mkeller0815/VC4000MultiROM/doc/IMG_2645.JPG

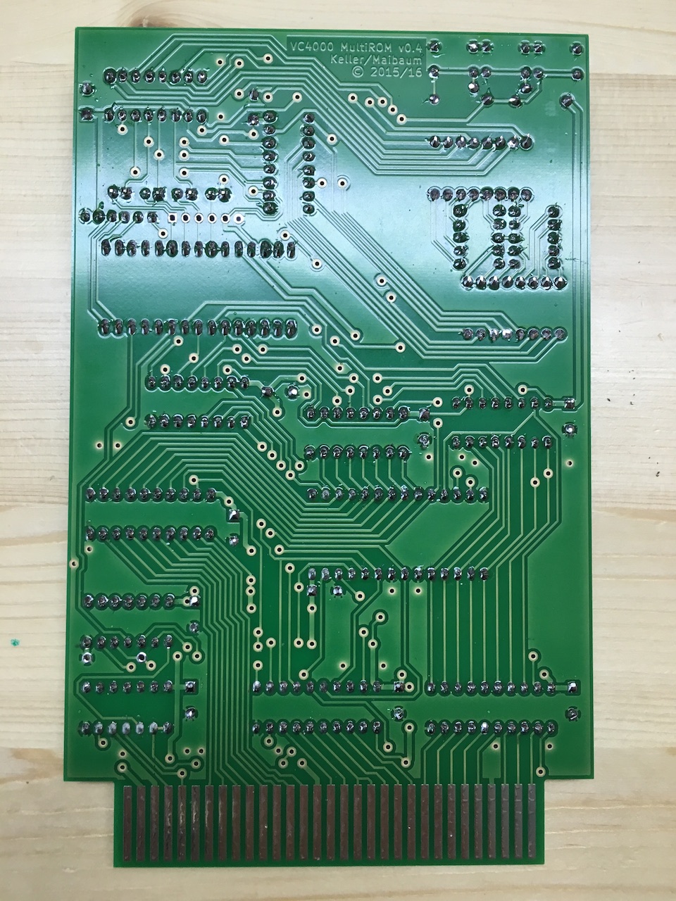
doc/IMG_2645.JPG
