mkeller0815/VC4000MultiROM/doc/IMG_2644.JPG

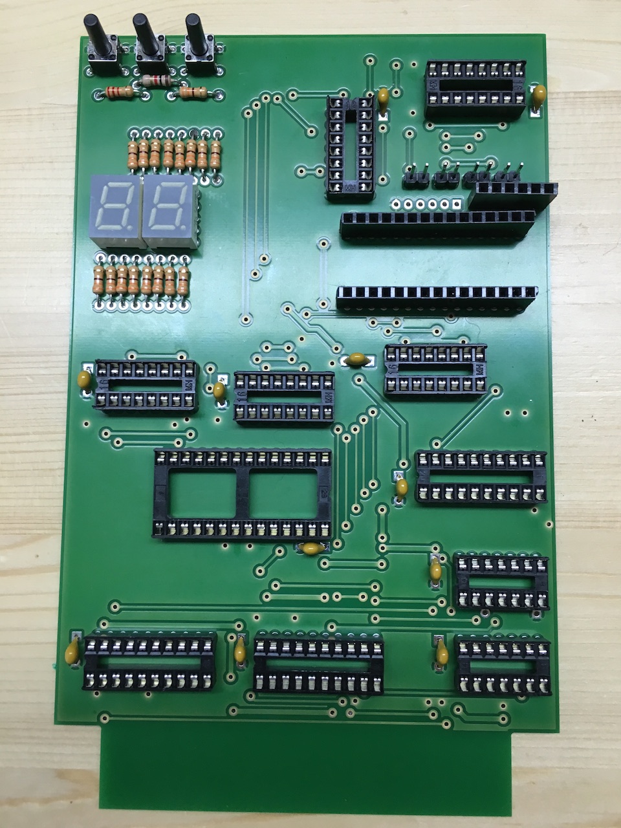
doc/IMG_2644.JPG
