mkeller0815/VC4000MultiROM/README.md

VC4000 MultiRom Modul
=====================

This is the approach to implement a MultiRom modul for the Interton VC4000.

![Overview] (https://github.com/mkeller0815/VC4000MultiROM/blob/master/doc/multirom_overview.jpg)
