mkeller0815/VC4000MultiROM/doc/README.md

Overview of ROM compatibility
=============================

Status Explanation (from good to bad)
-------------------------------------
*WORKS* - Seems to work, e.g. the game LOADS, starts and is playable. Did not
test every corner case, though.

*LOADS* – It loads into some 'stable' start screen, but does not seem
playable. Could mean, that I just don't now how to play this game, but just
tried to press any button and did not see any reaction on screen.

*FAILS* – Does not load, glitches horribly, or is not playable at all for any
other reason.

*n/a* – Not yet tested.

ROM Status Table
----------------

**Statistics at 43c7404**
- *WORKS:* 24/40 (60%)
- *LOADS:* 4/40 (10%)
- *FAILS:* 12/40 (30%)

ROM file     | Type | Status | Last tested with FW commit
------------:|:-----|:-------|---------------------------
 4inarow.bin | 2K   | WORKS  | 533253a
asattack.bin | 2K   | WORKS  | 533253a
asbattle.bin | 2K   | WORKS  | 533253a
backgamn.bin | 4K+1K| WORKS  | 533253a
blackjac.bin | 2K   | WORKS  | 533253a
 bowling.bin | 2K   | WORKS  | 533253a
  boxing.bin | 4K   | WORKS  | 533253a
 capture.bin | 2K   | WORKS  | 533253a
carraces.bin | 2K   | WORKS  | 533253a
  casino.bin | 2K   | WORKS  | 533253a
  chess1.bin | 4K+1K| WORKS  | 533253a
  chess2.bin | 6K+1K| FAILS  | 5a9af7a
 codebrk.bin | 2K   | WORKS  | 43c7404
 combata.bin | 2K   | WORKS  | 533253a
 combatb.bin | 2K   | WORKS  | 533253a
  cowboy.bin | 2K   | WORKS  | 43c7404
 draughts.bin| 4K+1K| WORKS  | 533253a
grndprix.bin | 2K   | WORKS  | 533253a
  headon.bin | 2K   | WORKS  | 43c7404
hippodro.bin | 2K   | WORKS  | 533253a
horsrace.bin | 2K   | WORKS  | 533253a
 hunting.bin | 2K   | WORKS  | 43c7404
hyprspac.bin | 2K   | WORKS  | 533253a
invadera.bin | 2K   | WORKS  | 43c7404
invaderb.bin | 2K   | WORKS  | 43c7404
knockout.bin | 2K   | WORKS  | 43c7404
labyrint.bin | 2K   | WORKS  | 43c7404
laseratt.bin | 2K   | WORKS  | 43c7404
mathema1.bin | 2K   | WORKS  | 533253a
mathema2.bin | 2K   | WORKS  | 533253a
mmuncher.bin | 2K   | WORKS  | 43c7404
musicalg.bin | 2K   | WORKS  | 43c7404
olympics.bin | 2K   | WORKS  | 43c7404
pinballa.bin | 2K   | WORKS  | 43c7404
pinballb.bin | 2K   | WORKS  | 43c7404
planetde.bin | 2K   | WORKS  | 43c7404
shootgal.bin | 2K   | WORKS  | 43c7404
shootout.bin | 2K   | WORKS  | 43c7404
 soccera.bin | 2K   | WORKS  | 43c7404
 soccerb.bin | 2K   | WORKS  | 43c7404
solitair.bin | 2K   | WORKS  | 533253a
spacewar.bin | 2K   | WORKS  | 43c7404
superinv.bin | 2K   | WORKS  | 533253a
suprmaze.bin | 2K   | WORKS  | 43c7404
treasure.bin | 2K   | WORKS  | 43c7404
