mkeller0815/VC4000MultiROM/doc/IMG_2646.JPG

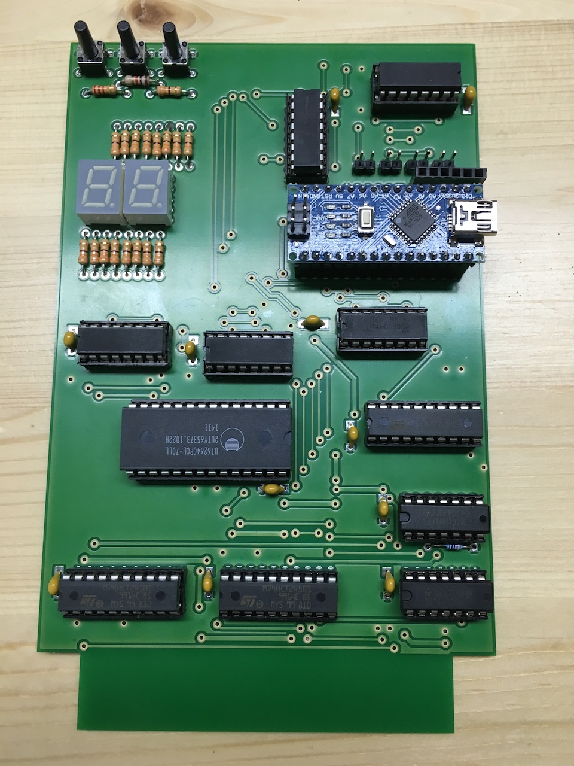
doc/IMG_2646.JPG
