mkeller0815/VC4000MultiROM/doc/multirom_overview.jpg

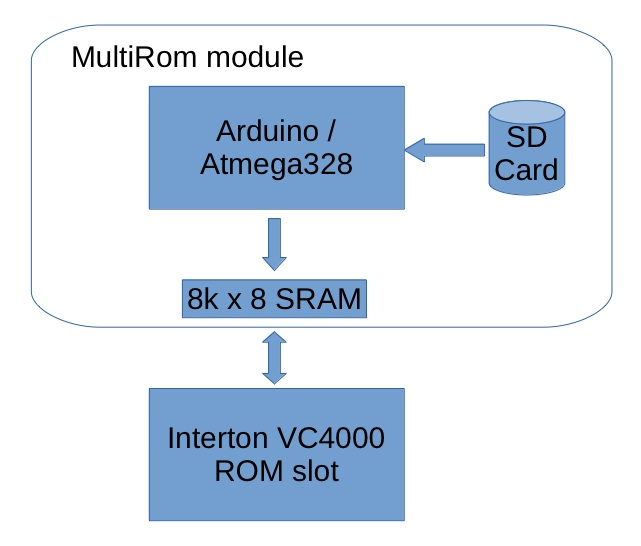
doc/multirom_overview.jpg
