mkeller0815/VC4000MultiROM/(list of files, drawings)

Other design files:
hardware/ROMCardPrototype/Mutilrom_1.dip
