mkeller0815/VC4000MultiROM/hardware/MultiRomCard.kicad_pcb

## KiCad design hardware/MultiRomCard.kicad_pcb (2016-09-15)

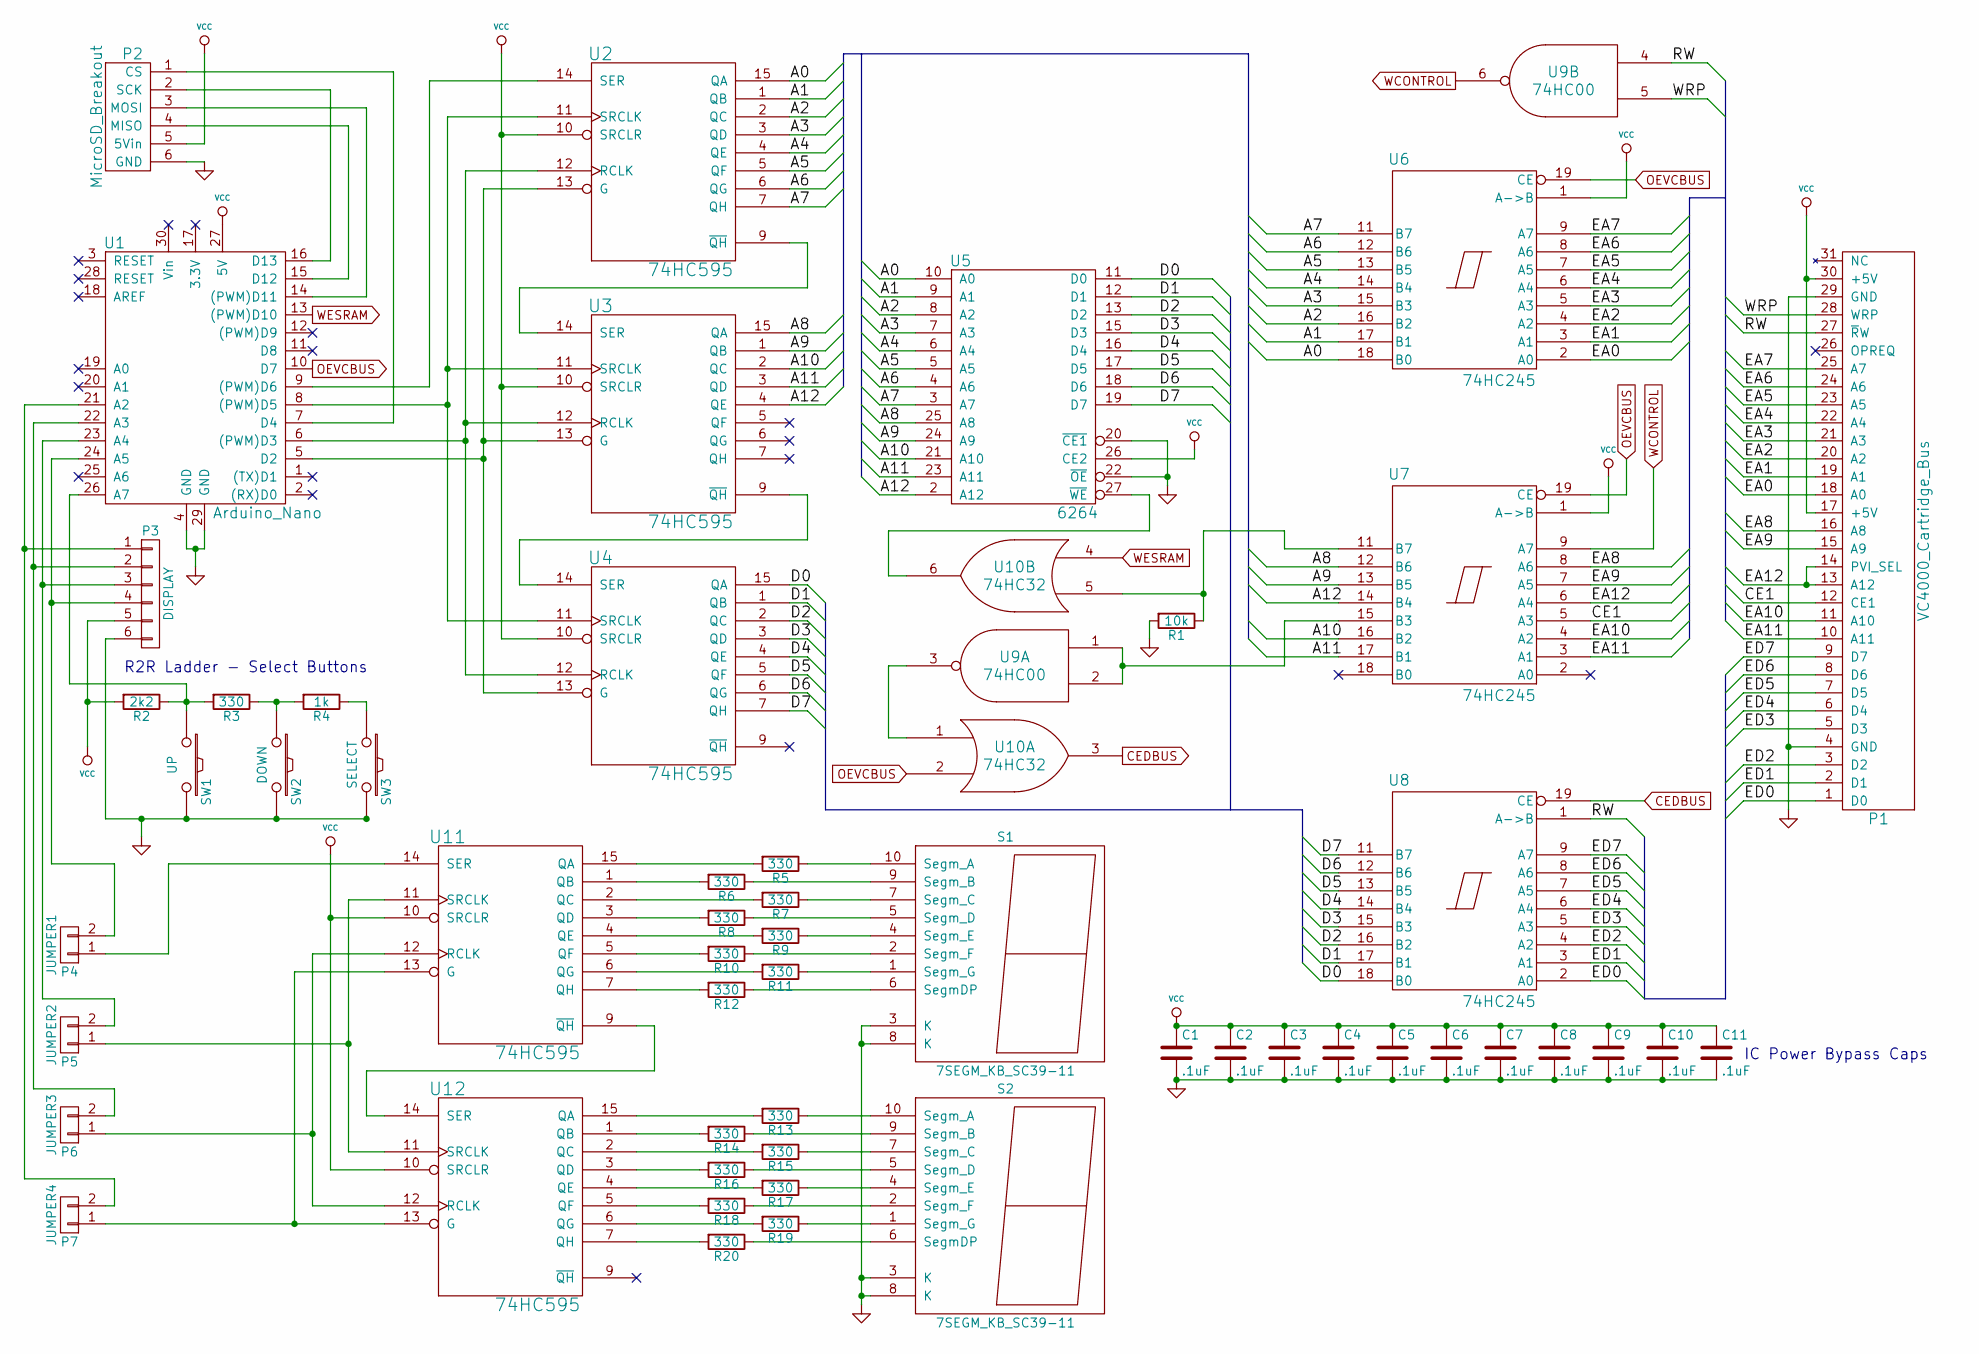
[picture p5: schematic MultiRomCard.sch, Interton VC4000 MultiRom Cartridge]

Parts:
C1, C2, C3, C4, C5, C6, C7, C8, C9, C10, C11: .1uF; C_Rect_L7_W2_P5_DIY
P1: VC4000_Cartridge_Bus; VC4000_CartridgeBus
P2: MicroSD_Breakout; Pin_Header_Straight_1x06
P3: DISPLAY; Pin_Header_Straight_1x06
P4: JUMPER1; Pin_Header_Straight_1x02
P5: JUMPER2; Pin_Header_Straight_1x02
P6: JUMPER3; Pin_Header_Straight_1x02
P7: JUMPER4; Pin_Header_Straight_1x02
R1: 10k; Resistor_Horizontal_RM10mm
R2: 2k2; Resistor_Horizontal_RM10mm
R3, R5, R6, R7, R8, R9, R10, R11, R12, R13, R14, R15, R16, R17, R18, R19, R20: 330; Resistor_Horizontal_RM10mm
R4: 1k; Resistor_Horizontal_RM10mm
S1, S2: 7SEGM_KB_SC39-11; 7_Segment_Display_KB_13_10mm
SW1: UP; SW_PUSH_SMALL
SW2: DOWN; SW_PUSH_SMALL
SW3: SELECT; SW_PUSH_SMALL
U1: Arduino_Nano
U2, U3, U4, U11, U12: 74HC595; DIP-16_W7.62mm_LongPads
U5: 6264; DIP-28_W15.24mm_LongPads
U6, U7, U8: 74HC245; DIP-20_W7.62mm_LongPads
U9: 74HC00; DIP-14_W7.62mm_LongPads
U10: 74HC32; DIP-14_W7.62mm_LongPads

Connections:
/A0: U2.15 (QA), U5.10 (A0), U6.18 (B0)
/A1: U2.1 (QB), U5.9 (A1), U6.17 (B1)
/A2: U2.2 (QC), U5.8 (A2), U6.16 (B2)
/A3: U2.3 (QD), U5.7 (A3), U6.15 (B3)
/A4: U2.4 (QE), U5.6 (A4), U6.14 (B4)
/A5: U2.5 (QF), U5.5 (A5), U6.13 (B5)
/A6: U2.6 (QG), U5.4 (A6), U6.12 (B6)
/A7: U2.7 (QH), U5.3 (A7), U6.11 (B7)
/A8: U3.15 (QA), U5.25 (A8), U7.12 (B6)
/A9: U3.1 (QB), U5.24 (A9), U7.13 (B5)
/A10: U3.2 (QC), U5.21 (A10), U7.16 (B2)
/A11: U3.3 (QD), U5.23 (A11), U7.17 (B1)
/A12: U3.4 (QE), U5.2 (A12), U7.14 (B4)
/CE1: P1.12 (CE1), U7.5 (A3)
/D0: U4.15 (QA), U5.11 (D0), U8.18 (B0)
/D1: U4.1 (QB), U5.12 (D1), U8.17 (B1)
/D2: U4.2 (QC), U5.13 (D2), U8.16 (B2)
/D3: U4.3 (QD), U5.15 (D3), U8.15 (B3)
/D4: U4.4 (QE), U5.16 (D4), U8.14 (B4)
/D5: U4.5 (QF), U5.17 (D5), U8.13 (B5)
/D6: U4.6 (QG), U5.18 (D6), U8.12 (B6)
/D7: U4.7 (QH), U5.19 (D7), U8.11 (B7)
/EA0: P1.18 (A0), U6.2 (A0)
/EA1: P1.19 (A1), U6.3 (A1)
/EA2: P1.20 (A2), U6.4 (A2)
/EA3: P1.21 (A3), U6.5 (A3)
/EA4: P1.22 (A4), U6.6 (A4)
/EA5: P1.23 (A5), U6.7 (A5)
/EA6: P1.24 (A6), U6.8 (A6)
/EA7: P1.25 (A7), U6.9 (A7)
/EA8: P1.16 (A8), U7.8 (A6)
/EA9: P1.15 (A9), U7.7 (A5)
/EA10: P1.11 (A10), U7.4 (A2)
/EA11: P1.10 (A11), U7.3 (A1)
/EA12: P1.13 (A12), P1.14 (PVI_SEL), U7.6 (A4)
/ED0: P1.1 (D0), U8.2 (A0)
/ED1: P1.2 (D1), U8.3 (A1)
/ED2: P1.3 (D2), U8.4 (A2)
/ED3: P1.5 (D3), U8.5 (A3)
/ED4: P1.6 (D4), U8.6 (A4)
/ED5: P1.7 (D5), U8.7 (A5)
/ED6: P1.8 (D6), U8.8 (A6)
/ED7: P1.9 (D7), U8.9 (A7)
/RW: P1.27 (~R~W), U8.1 (A->B), U9.4
/WRP: P1.28 (WRP), U9.5
CEDBUS: U8.19 (CE), U10.3
GND: C1.2, C2.2, C3.2, C4.2, C5.2, C6.2, C7.2, C8.2, C9.2, C10.2, C11.2, P1.4 (GND), P1.29 (GND), P2.6 (GND), P3.6, R1.2, S1.3 (K), S1.8 (K), S2.3 (K), S2.8 (K), SW1.2, SW2.2, SW3.2, U1.4 (GND), U1.29 (GND), U2.8 (GND), U3.8 (GND), U4.8 (GND), U5.14 (GND), U5.20 (~CE1), U5.22 (~OE), U6.10 (GND), U7.10 (GND), U8.10 (GND), U9.7 (GND), U10.7 (GND), U11.8 (GND), U12.8 (GND)
unnamed: P2.1 (CS), U1.7 (D4)
unnamed: P2.2 (SCK), U1.16 (D13)
unnamed: P2.3 (MOSI), U1.14 ((PWM)D11)
unnamed: P2.4 (MISO), U1.15 (D12)
unnamed: P3.1, P7.2, U1.21 (A2)
unnamed: P3.2, P6.2, U1.22 (A3)
unnamed: P3.3, P5.2, U1.23 (A4)
unnamed: P3.4, P4.2, U1.24 (A5)
unnamed: P4.1, U11.14 (SER)
unnamed: P5.1, U11.11 (SRCLK), U12.11 (SRCLK)
unnamed: P6.1, U11.12 (RCLK), U12.12 (RCLK)
unnamed: P7.1, U11.13 (G), U12.13 (G)
unnamed: R1.1, U7.11 (B7), U10.5
unnamed: R2.1, R3.2, SW1.1, U1.26 (A7)
unnamed: R3.1, R4.2, SW2.1
unnamed: R4.1, SW3.1
unnamed: R5.1, S1.10 (Segm_A)
unnamed: R5.2, U11.15 (QA)
unnamed: R6.1, S1.9 (Segm_B)
unnamed: R6.2, U11.1 (QB)
unnamed: R7.1, S1.7 (Segm_C)
unnamed: R7.2, U11.2 (QC)
unnamed: R8.1, S1.5 (Segm_D)
unnamed: R8.2, U11.3 (QD)
unnamed: R9.1, S1.4 (Segm_E)
unnamed: R9.2, U11.4 (QE)
unnamed: R10.1, S1.2 (Segm_F)
unnamed: R10.2, U11.5 (QF)
unnamed: R11.1, S1.1 (Segm_G)
unnamed: R11.2, U11.6 (QG)
unnamed: R12.1, S1.6 (SegmDP)
unnamed: R12.2, U11.7 (QH)
unnamed: R13.1, S2.10 (Segm_A)
unnamed: R13.2, U12.15 (QA)
unnamed: R14.1, S2.9 (Segm_B)
unnamed: R14.2, U12.1 (QB)
unnamed: R15.1, S2.7 (Segm_C)
unnamed: R15.2, U12.2 (QC)
unnamed: R16.1, S2.5 (Segm_D)
unnamed: R16.2, U12.3 (QD)
unnamed: R17.1, S2.4 (Segm_E)
unnamed: R17.2, U12.4 (QE)
unnamed: R18.1, S2.2 (Segm_F)
unnamed: R18.2, U12.5 (QF)
unnamed: R19.1, S2.1 (Segm_G)
unnamed: R19.2, U12.6 (QG)
unnamed: R20.1, S2.6 (SegmDP)
unnamed: R20.2, U12.7 (QH)
unnamed: U1.5 (D2), U2.13 (G), U3.13 (G), U4.13 (G)
unnamed: U1.6 ((PWM)D3), U2.12 (RCLK), U3.12 (RCLK), U4.12 (RCLK)
unnamed: U1.8 ((PWM)D5), U2.11 (SRCLK), U3.11 (SRCLK), U4.11 (SRCLK)
unnamed: U1.9 ((PWM)D6), U2.14 (SER)
unnamed: U2.9 (~QH), U3.14 (SER)
unnamed: U3.9 (~QH), U4.14 (SER)
unnamed: U7.15 (B3), U9.1, U9.2
unnamed: U9.3, U10.1
unnamed: U5.27 (~WE), U10.6
unnamed: U11.9 (~QH), U12.14 (SER)
OEVCBUS: U1.10 (D7), U6.19 (CE), U7.19 (CE), U10.2
VCC: C1.1, C2.1, C3.1, C4.1, C5.1, C6.1, C7.1, C8.1, C9.1, C10.1, C11.1, P1.17 (+5V), P1.30 (+5V), P2.5 (5Vin), P3.5, R2.2, U1.27 (5V), U2.10 (SRCLR), U2.16 (VCC), U3.10 (SRCLR), U3.16 (VCC), U4.10 (SRCLR), U4.16 (VCC), U5.26 (CE2), U5.28 (VCC), U6.1 (A->B), U6.20 (VCC), U7.1 (A->B), U7.20 (VCC), U8.20 (VCC), U9.14 (VCC), U10.14 (VCC), U11.10 (SRCLR), U11.16 (VCC), U12.10 (SRCLR), U12.16 (VCC)
WCONTROL: U7.9 (A7), U9.6
WESRAM: U1.13 ((PWM)D10), U10.4

Notes on the sheet:
IC Power Bypass Caps
R2R Ladder - Select Buttons

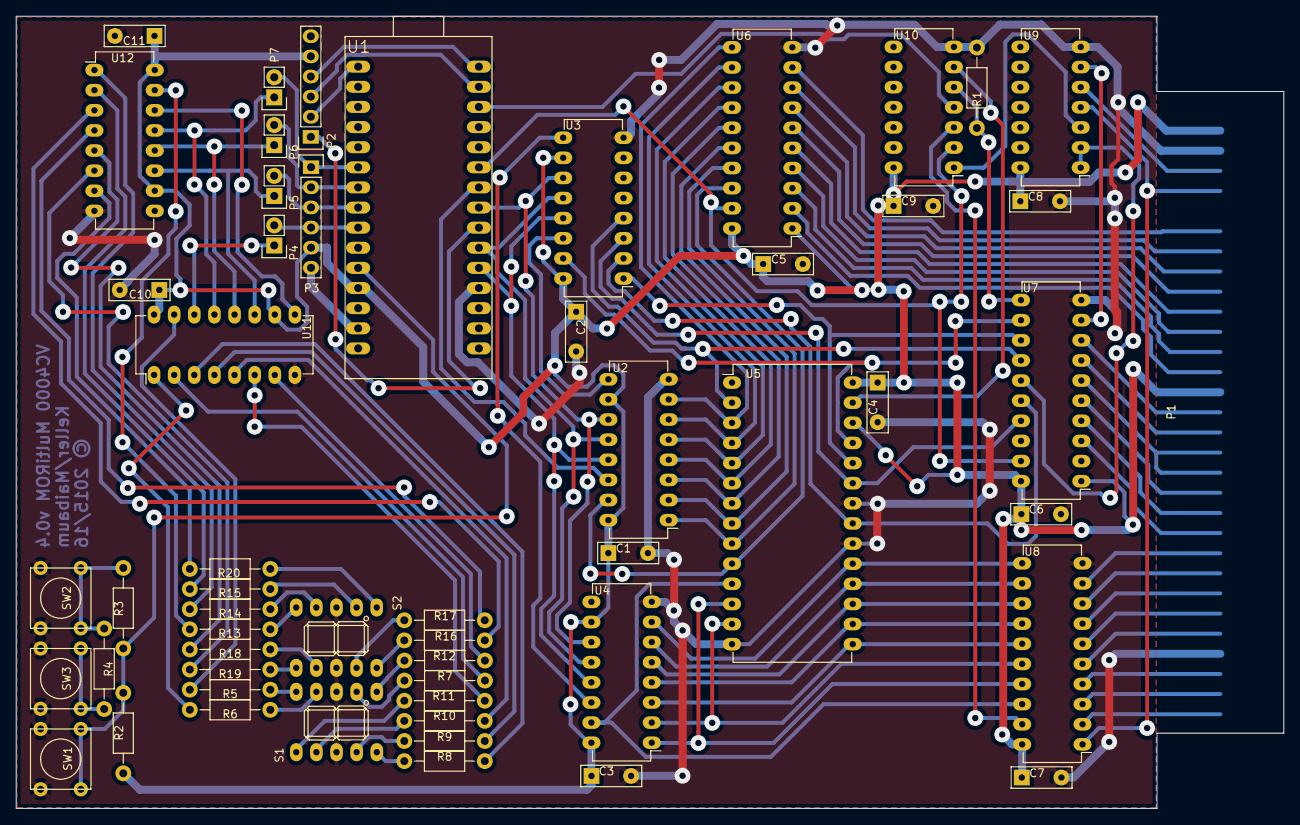
[picture p6: board MultiRomCard.kicad_pcb from above]

Board: 2 copper layers, 160.0 x 100.0 mm, 55 parts (0 on the bottom side), 109 nets.
