mkeller0815/VC4000MultiROM/firmware/MultiRomVC4000/MultiRomVC4000.ino

#include <SD.h>
#include <SPI.h>            // Needed for SD lib

// Defines for Arduino port numbers
#define CLOCK          5  // SRCLK (A/D-Bus Shift Registers)
#define LATCH          3  // RCLK  (A/D-Bus Shift Registers)
#define DATA           6  // SER   (A/D-Bus Shift Registers)
#define OESHIFT        2  // _G    (A/D-Bus Shift Registers)
#define WESRAM        10
#define OEVCBUS        7  // OE for Bus Transceivers
#define SD_CS          4  // Chip Select for SD card

#define DISP_OE       A2  // 7-segment display
#define DISP_LATCH    A3  // 7-segment display
#define DISP_CLK      A4  // 7-segment display
#define DISP_DATA     A5  // 7-segment display

// Miscellaneous other defines
#define NOKEY           0
#define UPKEY           1
#define DOWNKEY         2
#define SELECTKEY       3
#define MAX_ROMS       99
#define MAX_ROM_SIZE 8192
#define GO_MSG          9  // 7-segment Message offset
#define ER_MSG         11  // 7-segment Message offset

// Global variables
byte lastkey = NOKEY;
byte message = GO_MSG;
byte romNumber = 1;
char romName[] = { 0, 0, 0, 0, 0, 0, 0 };
File romFile;
byte SevenSegChar[]= {
  0x3f,  // 0
  0x06,  // 1
  0x5b,  // 2
  0x4f,  // 3
  0x66,  // 4
  0x6d,  // 5
  0x7d,  // 6
  0x07,  // 7
  0x7f,  // 8
  0x6f,  // 9
  0x63,  // o \
  0x79,  // E  |- Additional characters for status messages
  0x50   // r /
};

void setup() {
  pinMode(SD_CS, OUTPUT);
  pinMode(CLOCK, OUTPUT);
  pinMode(LATCH, OUTPUT);
  pinMode(DATA, OUTPUT);
  pinMode(WESRAM, OUTPUT);
  pinMode(OESHIFT, OUTPUT);
  pinMode(OEVCBUS, OUTPUT);
  pinMode(DISP_LATCH, OUTPUT);
  pinMode(DISP_CLK, OUTPUT);
  pinMode(DISP_DATA, OUTPUT);
  pinMode(DISP_OE, OUTPUT);

  // Isolate MultiROM from console bus
  disableVCBus();

  // Enable 7-segment display
  digitalWrite(DISP_OE,LOW);

  // Initialize SD card
  if (SD.begin(SD_CS)) {
    // Wait for user selecting a ROM number
    dispShowNumber(romNumber);
    byte key = getKey(A7);
    do {
      if (key == UPKEY && lastkey != UPKEY && romNumber < MAX_ROMS)
        ++romNumber;
      else if (key == DOWNKEY && lastkey != DOWNKEY && romNumber > 1)
        --romNumber;
      dispShowNumber(romNumber);
      lastkey = key;
      key = getKey(A7);
    } while (key != SELECTKEY);

    // Construct ROM file name
    if (romNumber < 10) {
      romName[0] = '0';
      itoa(romNumber, romName+1, 10);
    } else {
      itoa(romNumber, romName, 10);
    }
    strcpy(romName+2, ".bin");  // Append filename extension

    // Open ROM file
    romFile = SD.open(romName);

    // Write ROM file to SRAM
    if (romFile) {
      unsigned romSize = static_cast<unsigned>(romFile.size());
      if (romSize <= MAX_ROM_SIZE) {
        for (unsigned i = 0; i < romSize; i++) {
          write2RAM(i, romFile.read());
        }
      } else {
        // ROM size too big.
        message = ER_MSG;
      }
      romFile.close();
      enableVCBus();
    } else {
      // ROM file could not be opened.
      message = ER_MSG;
    }
  } else {
    // SD card not found or otherwise failing initialization
    message = ER_MSG;
  }
}

void loop() {
  // Status indication
  dispMessage(message);
}

void disableVCBus() {
  digitalWrite(WESRAM, HIGH);
  digitalWrite(OESHIFT, LOW);
  digitalWrite(OEVCBUS, HIGH);
}

void enableVCBus() {
  digitalWrite(WESRAM, HIGH);
  digitalWrite(OESHIFT, HIGH);
  digitalWrite(OEVCBUS, LOW);
  delay(100);
  // handover R/W control to VC4000
  digitalWrite(WESRAM, LOW);
}

void write2RAM(unsigned int address, byte data) {
  digitalWrite(OESHIFT, LOW);
  digitalWrite(WESRAM, HIGH);
  shiftout(address, data);
  digitalWrite(WESRAM, LOW);
  delayMicroseconds(10);
  digitalWrite(WESRAM, HIGH);
}

void shiftout(unsigned int address, byte data) {
  byte lowbyte = address & 0xff;
  byte highbyte = address >> 8;

  digitalWrite(LATCH, LOW);
  shiftOut(DATA, CLOCK, MSBFIRST, data);
  shiftOut(DATA, CLOCK, MSBFIRST, highbyte);
  shiftOut(DATA, CLOCK, MSBFIRST, lowbyte);
  digitalWrite(LATCH, HIGH);
  delayMicroseconds(10);
  digitalWrite(LATCH, LOW);
}

byte getKey(int pin) {
  int v = analogRead(pin);
  delay(50);
  v = analogRead(pin);
  if (v < 600 && v > 300)
    return DOWNKEY;
  if (v < 300 && v > 100)
    return SELECTKEY;
  if (v < 100)
    return UPKEY;
  return NOKEY;
}

void dispShowNumber(byte num) {
  byte i = num % 10;
  byte j = (num - i) / 10;
  digitalWrite(DISP_LATCH, LOW);
  shiftOut(DISP_DATA, DISP_CLK, MSBFIRST, SevenSegChar[i]); // digitTwo
  shiftOut(DISP_DATA, DISP_CLK, MSBFIRST, SevenSegChar[j]); // digitOne
  digitalWrite(DISP_LATCH, HIGH);
}

void dispMessage(byte offset) {
  digitalWrite(DISP_LATCH, LOW);
  shiftOut(DISP_DATA, DISP_CLK, MSBFIRST, SevenSegChar[offset+1]);
  shiftOut(DISP_DATA, DISP_CLK, MSBFIRST, SevenSegChar[offset]);
  digitalWrite(DISP_LATCH, HIGH);
}
