mkeller0815/VC4000MultiROM/(commit log)

2014-11-28 dded some comments to the current firmware code
2014-11-28 added new files
    [Mutilrom_1.dip]
2015-02-04 added new MultiROM Arduino Firmware
2015-02-05 added pinout document for ROM slot new test firmware version
2015-02-11 Add initial Kicad project files.
    [MultiRomCard.kicad_pcb, MultiRomCard.sch]
2015-02-11 Add README for the Kicad project directory.
2015-02-11 Hopefully correct the link to the schematic SVG.
2015-02-12 Add Kicad specific .gitignore.
2015-02-17 Correct schematic error: DIR pin logic swap on bus transcievers.
    [MultiRomCard.sch]
2015-02-17 Schematic: Remove left-over junction.
    [MultiRomCard.sch]
2015-02-25 Small cosmetic changes in schematic
    - Account for changes in Kicad symbol libraries that affected power
    symbols GND and VCC.
    [MultiRomCard.sch]
2015-02-25 added new test sketch for 74hc245 testing on arduino mega
2015-02-28 Make most pin properties of VC4000_Cartridge_Bus passive to silence Eeschema DRC.
    [MultiRomCard.sch]
2015-03-07 Schematic: Change size of global labels.
    [MultiRomCard.sch]
2015-03-19 updated SRAM /CE1 & CE2 connection to Arduino and bus transceiver
    [MultiRomCard.sch]
2015-03-20 Updated date string in Schematic.
    [MultiRomCard.sch]
2015-04-23 Preparations for PCB layout
    - Created footprints for Cartridge Bus and Arduino UNO,
    - Modified Arduino UNO schematic symbol to include pin numbers,
    - Created initial netlist, and
    - Spread all footprints on board, no traces yet.
    [MultiRomCard.kicad_pcb, MultiRomCard.sch]
2015-04-26 Cartridge bus footprint: Move net connections towards the edges.
2015-04-26 Euro PCB outline and some part changes (BREAKS CURRENT FIRMWARE!)
    - Swapped A and B sides on Bus transcievers for easier tracing.
    (Not sure if this is ideal, yet, but certainly better than
    before!). THIS BREAKS CURRENT FIRMWARE! Need to change
    direction bits!
    - Prefix bus labels from the cartridge to the transcievers with 'E'
    (for 'external') to de-confuse Pcbnew.
    - Connect second +5V and GND connectors to power nets for easier
    board connections.
    - revert previous changes to cartridge bus footprint.
    [MultiRomCard.kicad_pcb, MultiRomCard.sch]
2015-05-06 Move "CE2" track to another BT pin and remove special.lib.
    [MultiRomCard.kicad_pcb, MultiRomCard.sch]
2015-05-06 Updated SVG schematic.
    [MultiRomCard.sch]
2015-05-06 Move footprints a little.
    [MultiRomCard.kicad_pcb]
2015-05-06 First attempt at routing.
    [MultiRomCard.kicad_pcb]
2015-05-21 [PCB] First version with all nets connected.
    [MultiRomCard.kicad_pcb]
2015-05-21 Ignore Pcbnew’s auto-backups.
2015-05-21 [PCB] True first version with all nets connected.
    [MultiRomCard.kicad_pcb]
2015-05-21 Added SVG of PCB, updated README accordingly.
2015-05-21 Corrected link to Kicad install instructions in README.
2015-05-26 [PCB] Add ground copper zone; minor reroutings.
    [MultiRomCard.kicad_pcb]
2015-06-20 [PCB] Make Cartridge Bus Pins 1mm longer.
    [MultiRomCard.kicad_pcb]
2015-06-20 [SCH] Corrected an error with the internal address bus.
    [MultiRomCard.kicad_pcb, MultiRomCard.sch]
2015-06-20 [SCH/PCB] Added IC power decoupling caps.
    [MultiRomCard.kicad_pcb, MultiRomCard.sch]
2015-06-20 Remove .cmp file as it is no longer needed.
    (Recent changes in Kicad made this file obsolete.)
2015-06-20 [PCB] Added missing last connection.
    [MultiRomCard.kicad_pcb]
2015-06-20 [PCB] Corrected DRC error (track near pad).
    [MultiRomCard.kicad_pcb]
2015-06-20 [PCB] Corrected typo in board credits.
    [MultiRomCard.kicad_pcb]
2015-06-20 [SCH/PCB] Match credits in both Schematic and PCB.
    [MultiRomCard.kicad_pcb, MultiRomCard.sch]
2015-06-21 [SCH/PCB] Added and connected missing Arduino GND Pins.
    [MultiRomCard.kicad_pcb, MultiRomCard.sch]
2015-06-22 [SCH/PCB] Cleaning up both schematic and PCB a bit.
    [MultiRomCard.kicad_pcb, MultiRomCard.sch]
2015-06-22 [SCH/PCB] Add Pin header for MicroSD Card Breakout Board.
    [MultiRomCard.kicad_pcb, MultiRomCard.sch]
2015-06-22 [PCB] Slightly bigger drill holes for Arduino footprint.
    [MultiRomCard.kicad_pcb]
2015-06-22 [SCHSYM] Add footprint filter to current custom schematic symbols.
2015-06-22 [SCH/PCB] Replace Arduino UNO by Arduino Nano
    - TODO: Shrink board outlines to account for smaller Arduino board.
    [MultiRomCard.kicad_pcb, MultiRomCard.sch]
2015-06-23 [PCB] Some minor routing improvements.
    [MultiRomCard.kicad_pcb]
2015-06-25 [PCB] Increase one inner GND zone a little.
    [MultiRomCard.kicad_pcb]
2015-06-25 [PCB] Shrink PCB to fit closer to the now used Arduino Nano.
    [MultiRomCard.kicad_pcb]
2015-06-25 [SCH/PCB] Add pin header for testing purposes.
    [MultiRomCard.kicad_pcb, MultiRomCard.sch]
2015-06-29 [PCB] Change GND copper zone a bit.
    [MultiRomCard.kicad_pcb]
2015-06-29 [SCH/PCB] Correct 74HC245 direction pins.
    [MultiRomCard.kicad_pcb, MultiRomCard.sch]
2015-06-29 Added printouts.
2015-06-29 [PCB] Corrected printout (was not mirrored).
    [MultiRomCard.kicad_pcb]
2015-07-20 [PCB] Added USB connector overhang to Arduino Nano footprint.
    [MultiRomCard.kicad_pcb]
2015-07-21 [SCH/PCB] Corrected wrong analog pin numbering in Arduino Nano symbol.
    [MultiRomCard.kicad_pcb, MultiRomCard.sch]
2015-07-21 [FW] Several changes to account for prototype PCB
    - Swap 595 OE pins for data and address bus
    - Fixed off-by-one error in SRAM copy code
    - Fixed occasional bug with CE1/CE2 pins on Arduino
    which could stay at +5V if they were HIGH before
    switching them to INPUT (high-Z) mode.
    - Move status LED blinking code into loop()
    - Removed some trailing whitespace in source file.
2015-07-21 Clean up firmware folder.
    - The current firmware is called MultiRomVC4000.ino
    - Old code and test tools have been moved to old/
2015-07-21 Move old hardware layout out of the way.
    [Mutilrom_1.dip]
2015-07-21 Move contents of Kicad folder to root hardware folder.
    [MultiRomCard.kicad_pcb, MultiRomCard.sch]
2015-07-22 [SCH/PCB] A12+PVI_SEL needs to be connected to /CE1.
    [MultiRomCard.kicad_pcb, MultiRomCard.sch]
2015-07-22 [SCH] Minimal cosmetic changes.
    [MultiRomCard.sch]
2015-07-28 [SCH/PCB] Rotate MicroSD breakout header.
    [MultiRomCard.kicad_pcb, MultiRomCard.sch]
2015-08-03 [HW/FW] Incorporate latest changes into hardware and firmware.
    - From now on, we should call the hardware rev. 0.2.
    - All games should now work (ROM and ROM+RAM)
    - Up to 6K (5.5K) ROM is currently allowed (7.5K should be
    possible, too, with one line change in the FW.)
    [MultiRomCard.kicad_pcb, MultiRomCard.sch]
2015-08-04 version string added on copper side
    [MultiRomCard.kicad_pcb]
2015-08-04 [HW] A little cleanup on the schematic, new PDF printouts.
    [MultiRomCard.kicad_pcb, MultiRomCard.sch]
2015-08-16 added 3 push buttons and a display prot connected to I2C
    [MultiRomCard.kicad_pcb, MultiRomCard.sch]
2015-08-16 increased size of several vias for better soldering
    [MultiRomCard.kicad_pcb]
2015-08-19 [HW] PCB cleanup and new printouts.
    [MultiRomCard.kicad_pcb, MultiRomCard.sch]
2015-08-19 clean up of schema for additional components
    [MultiRomCard.kicad_pcb, MultiRomCard.sch]
2015-08-19 added 2x 7-segment displays and shift register for display
    [MultiRomCard.sch]
2015-08-21 [FW] Missing firmware changes for v. 0.2.
    [MultiRomVC4000.ino]
2015-08-23 [PCB] Some last optimizations for v. 0.2.
    [MultiRomCard.kicad_pcb]
2015-08-24 [HW] Update PCB to v. 0.3 (include 7-segm display).
    [MultiRomCard.kicad_pcb, MultiRomCard.sch]
2015-08-30 [PCB] New cap footprint with larger pads...
    - ... should allow for easier hand soldering.
    - Some minor reroutings to decrease copper loss when etching the board.
    [MultiRomCard.kicad_pcb, MultiRomCard.sch]
2015-09-01 added ground plane on front side
    [MultiRomCard.kicad_pcb]
2015-09-16 added I2C library
2015-09-17 [FW] Allow user selection of ROM file on-board.
2015-09-29 Cleanup in hardware folder:
    - Delete and ignore PCBNew's autosave files.
    - Delete duplicated PDF file of PCB layout (they belong into Printouts/)
2015-09-29 Add ROMdumper utility (Arduino Mega based).
2015-09-30 [FW] Re-introduce write delay
    Otherwise game #9 (Intelligenz I / Labyrinth) does not load correctly.
    [MultiRomVC4000.ino]
2015-09-30 [FW] Use delayMicroseconds() for write delay.
    Delay of 10us is intentional, since the function is only guaranteed
    to work reliably with 3us and larger values, so we better stay safe.
    A delay of 20us is still faster than the millisecond delay()!
2016-03-28 [PCB] Changes for v0.4
    - Arduino USB port to the border of the mainboard
    - Controls to the top
    - Add PDF printout of front copper layer
    [MultiRomCard.kicad_pcb]
2016-03-28 [SCH] Update for v0.4
    [MultiRomCard.sch]
2016-03-28 Removed ancient DipTrace layout file.
    [Mutilrom_1.dip]
2016-09-15 Corrected image links to SCH and PCB in hardware/README.md
2016-09-15 corrected soldermask layer for connector foodprint
    [MultiRomCard-B.Cu.gbr, MultiRomCard-B.Mask.gbr, MultiRomCard-B.SilkS.gbr, MultiRomCard-Edge.Cuts.gbr, MultiRomCard-F.Cu.gbr, MultiRomCard-F.Mask.gbr, MultiRomCard-F.SilkS.gbr, MultiRomCard.drl]
2016-09-15 Correct soldermask layer for all copper stripes in Cartridge Bus Footprint (in library).
2016-09-15 V0.4 soldered, pictures added
