mkeller0815/VC4000MultiROM/(notices)

Notices in the files:
hardware/MultiRomCard.kicad_pcb:
© 2015/16
